holingher/vumeter_IN13/(list of files, drawings)

Other design files:
01_HW/audio-board/audio_board_holy.dch
01_HW/audio-board/audio_board_holy.dip
01_HW/tube-board/tube_board_pebble.dch
01_HW/tube-board/tube_board_pebble.dip
