holingher/vumeter_IN13/01_HW/tube-offset-1/tube-offset-1.kicad_pcb

## KiCad design 01_HW/tube-offset-1/tube-offset-1.kicad_pcb (2023-09-11)

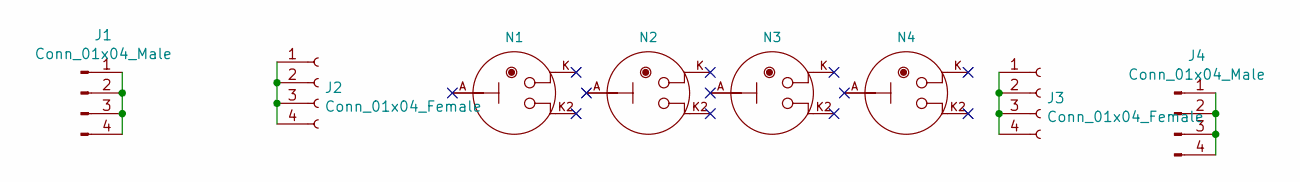
[picture p1: schematic tube-offset-1.sch]

Parts:
J1, J4: Conn_01x04_Male; PinSocket_1x04_P2.54mm_Vertical
J2, J3: Conn_01x04_Female; PinSocket_1x04_P2.54mm_Vertical
N1, N2, N3, N4: IN-13; fixed-IN-13-footprint

Connections:
unnamed: J1.1, J1.2, J1.3, J1.4
unnamed: J2.1, J2.2, J2.3, J2.4
unnamed: J3.1, J3.2, J3.3, J3.4
unnamed: J4.1, J4.2, J4.3, J4.4

Board: 2 copper layers, 8 parts (0 on the bottom side), 4 nets, no tracks yet.
