holingher/vumeter_IN13/(threads)

Thread 2 (2025-02-20):

Calibrate IN-13 !! PLZ !!!

0Bender, 2025-02-20:
I assembled your device and it worked from the first launch :)
I have only one question. How to adjust the lamp level? How to set the maximum on the dumps? Maybe there is some kind of calibration? Thank you.
