holingher/vumeter_IN13/(commit log)

2023-09-11 add source code for teensy4 (audio board) and reuse hardware from Will
    [audio-board.kicad_pcb, audio-board.kicad_sch, audio-board.sch, bottom.FCStd, tube-offset-1.kicad_pcb, tube-offset-1.sch, tube-offset-2.kicad_pcb, tube-offset-2.sch]
2024-01-28 Arduino port - tested
    [audio-board.kicad_pcb, audio-board.kicad_sch, audio-board.sch, audio_board_holy.dch, audio_board_holy.dip, bottom.FCStd, tube_board_pebble.dch, tube_board_pebble.dip]
2024-01-29 set PWM to 10 kHz
2024-02-02 change PWM freq to 46 kHz
2024-02-11 Fix PWM arduino
    Fix for PWM -> use 1uF instead of 0.1 uF on control.
    [audio_board_holy.dch, tube_board_pebble.dch]
2024-03-31 connect 4th uart
    [audio_board_holy.dip]
2024-04-14 update audio board
    [audio_board_holy.dip]
2024-05-05 code for 16 tubes and correct uart port
    [audio-board.ino]
2024-08-19 add Fan support
